bvksound/differentialprobe/DOCUMENTS/Links.txt

https://www.eevblog.com/forum/projects/high-voltage-differential-probe-design-for-review/25/
https://www.eevblog.com/forum/testgear/teardown-pintek-dp-25-differentail-probe/
https://www.eevblog.com/forum/testgear/_new-pro_-differential-probe/msg624988/#msg624988
http://bardagjy.com/?p=1664
http://electronicsplayground.blogspot.com/2015/07/high-voltage-differential-probe-design.html
