bvksound/differentialprobe/BOM/DifferentialProbe_BOM.xlsx

Sheet: BOM_THT
Component | Identical Parts | Section | Type | Part Number / Value | Obtainable | Remark | Alternative Found | Link 1 | Unit Price 1 | Link 2 | Unit Price 2 | Link 3 | Unit Price 3
C1 | C1,2,3,4,5,6 | Input Attenuation Stage | Ceramic Capacitor | 6n8F | Yes |  |  | HSE682SAQCF0KR Vishay / Draloric | Mouser Belgium (https://www.mouser.be/ProductDetail/Vishay-Draloric/HSE682SAQCF0KR?qs=6lQ0QAtkVxmQt2Vp%252BwyNXA%3D%3D) | 0.474
C2 | C1,2,3,4,5,6 | Input Attenuation Stage | Ceramic Capacitor | 6n8F | Yes |  |  | HSE682SAQCF0KR Vishay / Draloric | Mouser Belgium (https://www.mouser.be/ProductDetail/Vishay-Draloric/HSE682SAQCF0KR?qs=6lQ0QAtkVxmQt2Vp%252BwyNXA%3D%3D) | 0.474
C3 | C1,2,3,4,5,6 | Input Attenuation Stage | Ceramic Capacitor | 6n8F | Yes |  |  | HSE682SAQCF0KR Vishay / Draloric | Mouser Belgium (https://www.mouser.be/ProductDetail/Vishay-Draloric/HSE682SAQCF0KR?qs=6lQ0QAtkVxmQt2Vp%252BwyNXA%3D%3D) | 0.474
C4 | C1,2,3,4,5,6 | Input Attenuation Stage | Ceramic Capacitor | 6n8F | Yes |  |  | HSE682SAQCF0KR Vishay / Draloric | Mouser Belgium (https://www.mouser.be/ProductDetail/Vishay-Draloric/HSE682SAQCF0KR?qs=6lQ0QAtkVxmQt2Vp%252BwyNXA%3D%3D) | 0.474
C5 | C1,2,3,4,5,6 | Input Attenuation Stage | Ceramic Capacitor | 6n8F | Yes |  |  | HSE682SAQCF0KR Vishay / Draloric | Mouser Belgium (https://www.mouser.be/ProductDetail/Vishay-Draloric/HSE682SAQCF0KR?qs=6lQ0QAtkVxmQt2Vp%252BwyNXA%3D%3D) | 0.474
C6 | C1,2,3,4,5,6 | Input Attenuation Stage | Ceramic Capacitor | 6n8F | Yes |  |  | HSE682SAQCF0KR Vishay / Draloric | Mouser Belgium (https://www.mouser.be/ProductDetail/Vishay-Draloric/HSE682SAQCF0KR?qs=6lQ0QAtkVxmQt2Vp%252BwyNXA%3D%3D) | 0.474
C7 | C7,11 | Input Attenuation Stage | Ceramic Capacitor | 120pF | Yes |  |  | CC45SL3AD121JYVNA TDK | Mouser Belgium (https://www.mouser.be/ProductDetail/TDK/CC45SL3AD121JYVNA?qs=eSfX1CQlHqq1jQpjjENGKQ%3D%3D) | 0.27
C8 | C8,9,12,13 | Input Attenuation Stage | Ceramic Capacitor | 82pF | Yes |  |  | CC45SL3AD820JYNNA TDK | Mouser Belgium (https://www.mouser.be/ProductDetail/TDK/CC45SL3AD820JYNNA?qs=2FIyTMJ0hNlY1vHleNE%252B0A%3D%3D) | 0.26
C9 | C8,9,12,13 | Input Attenuation Stage | Ceramic Capacitor | 82pF | Yes |  |  | CC45SL3AD820JYNNA TDK | Mouser Belgium (https://www.mouser.be/ProductDetail/TDK/CC45SL3AD820JYNNA?qs=2FIyTMJ0hNlY1vHleNE%252B0A%3D%3D) | 0.26
C10 | C10,14 | Input Attenuation Stage | Variable Capacitor | 8.0-30.0pF |  | Variable capacitor for adjusting square wave compensation and high frequency CMRR |  | JZ300 Knowles Voltronics | Mouser Belgium (https://www.mouser.be/ProductDetail/Knowles-Voltronics/JZ300?qs=l0I8jaqwYiDrMk2Sd%252BO3uQ%3D%3D) | 2.72
C11 | C7,11 | Input Attenuation Stage | Ceramic Capacitor | 120pF | Yes |  |  | CC45SL3AD121JYVNA TDK | Mouser Belgium (https://www.mouser.be/ProductDetail/TDK/CC45SL3AD121JYVNA?qs=eSfX1CQlHqq1jQpjjENGKQ%3D%3D) | 0.27
C12 | C8,9,12,13 | Input Attenuation Stage | Ceramic Capacitor | 82pF | Yes |  |  | CC45SL3AD820JYNNA TDK | Mouser Belgium (https://www.mouser.be/ProductDetail/TDK/CC45SL3AD820JYNNA?qs=2FIyTMJ0hNlY1vHleNE%252B0A%3D%3D) | 0.26
C13 | C8,9,12,13 | Input Attenuation Stage | Ceramic Capacitor | 82pF | Yes |  |  | CC45SL3AD820JYNNA TDK | Mouser Belgium (https://www.mouser.be/ProductDetail/TDK/CC45SL3AD820JYNNA?qs=2FIyTMJ0hNlY1vHleNE%252B0A%3D%3D) | 0.26
C14 | C10,14 | Input Attenuation Stage | Variable Capacitor | 8.0-30.0pF |  | Variable capacitor for adjusting square wave compensation. |  | JZ300 Knowles Voltronics | Mouser Belgium (https://www.mouser.be/ProductDetail/Knowles-Voltronics/JZ300?qs=l0I8jaqwYiDrMk2Sd%252BO3uQ%3D%3D) | 2.72
C15 |  | JFET Buffer and Gain Stage | Ceramic Capacitor | 22pF | Yes |  |  | 1C10C0G220J050B Vishay | Mouser Belgium (https://www.mouser.be/ProductDetail/Vishay/1C10C0G220J050B?qs=%2FVYrxewl4mYopKLzL8PbyA%3D%3D) | 0.15
C16 | C16,19,20,21,26 | JFET Buffer and Gain Stage | Ceramic Capacitor | 100nF | Yes |  |  | Multilayer Ceramic Capacitor, 0.1 uF, 50 V, Mono-Kap Series, ± 10%, Radial Leaded, X7R (farnell.com) (https://be.farnell.com/vishay/k104k15x7rf53h5/cap-0-1-f-50v-10-x7r/dp/1141777) | 0.095
C17 |  | JFET Buffer and Gain Stage | Ceramic Capacitor | 68pF | Yes |  |  | D680J25SL0L6UJ5R Vishay / BC Components | Mouser Belgique (https://www.mouser.be/ProductDetail/Vishay-BC-Components/D680J25SL0L6UJ5R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) | 0.11
C18 |  | JFET Buffer and Gain Stage | Ceramic Capacitor | 33pF | Yes |  |  | CC45SL3DD330JYGNA TDK | Mouser Belgique (https://www.mouser.be/ProductDetail/TDK/CC45SL3DD330JYGNA?qs=eSfX1CQlHqpvQOwssXPbQg%3D%3D) | 0.31
C19 | C16,19,20,21,26 | JFET Buffer and Gain Stage | Ceramic Capacitor | 100nF | Yes |  |  | Multilayer Ceramic Capacitor, 0.1 uF, 50 V, Mono-Kap Series, ± 10%, Radial Leaded, X7R (farnell.com) (https://be.farnell.com/vishay/k104k15x7rf53h5/cap-0-1-f-50v-10-x7r/dp/1141777) | 0.095
C20 | C16,19,20,21,26 | JFET Buffer and Gain Stage | Ceramic Capacitor | 100nF | Yes |  |  | Multilayer Ceramic Capacitor, 0.1 uF, 50 V, Mono-Kap Series, ± 10%, Radial Leaded, X7R (farnell.com) (https://be.farnell.com/vishay/k104k15x7rf53h5/cap-0-1-f-50v-10-x7r/dp/1141777) | 0.095
C21 | C16,19,20,21,26 | JFET Buffer and Gain Stage | Ceramic Capacitor | 100nF | Yes |  |  | Multilayer Ceramic Capacitor, 0.1 uF, 50 V, Mono-Kap Series, ± 10%, Radial Leaded, X7R (farnell.com) (https://be.farnell.com/vishay/k104k15x7rf53h5/cap-0-1-f-50v-10-x7r/dp/1141777) | 0.095
C22 |  | JFET Buffer and Gain Stage | Ceramic Capacitor | 10nF | Yes |  |  | D103K43Y5PH6TJ5R Vishay / BC Components | Mouser Belgique (https://www.mouser.be/ProductDetail/Vishay-BC-Components/D103K43Y5PH6TJ5R?qs=wEmTtUuRSe6NCZwQxzdYuQ%3D%3D) | 0.29
C23 | C23,24 | Output Stage | Ceramic Capacitor | 6p8F | Yes |  |  | 561R10TCCV68BA Vishay / Cera-Mite | Mouser Belgique (https://www.mouser.be/ProductDetail/Vishay-Cera-Mite/561R10TCCV68BA?qs=XeJOwCSCkv%252BIxAC3i6sxEw%3D%3D) | 0.46
C24 | C23,24 | JFET Buffer and Gain Stage | Ceramic Capacitor | 6p8F | Yes |  |  | 561R10TCCV68BA Vishay / Cera-Mite | Mouser Belgique (https://www.mouser.be/ProductDetail/Vishay-Cera-Mite/561R10TCCV68BA?qs=XeJOwCSCkv%252BIxAC3i6sxEw%3D%3D) | 0.46
C26 | C16,19,20,21,26 | Output Stage | Ceramic Capacitor | 100nF | Yes |  |  | Multilayer Ceramic Capacitor, 0.1 uF, 50 V, Mono-Kap Series, ± 10%, Radial Leaded, X7R (farnell.com) (https://be.farnell.com/vishay/k104k15x7rf53h5/cap-0-1-f-50v-10-x7r/dp/1141777) | 0.095
C27 |  | Power Supply | Tantalum Capacitor | 4u7F 16V | Yes
C28 |  | Power Supply | Tantalum Capacitor | 4u7F 16V | Yes
C29 |  | Power Supply | Tantalum Capacitor | 4u7F 16V | Yes
C30 |  | Power Supply | Ceramic Capacitor | 100nF | Yes
C31 |  | Power Supply | Ceramic Capacitor | 33nF | Yes
C32 |  | Power Supply | Tantalum Capacitor | 1uF 25V | Yes
C33 |  | Power Supply | Ceramic Capacitor | 100nF | Yes
C34 |  | Power Supply | Ceramic Capacitor | 1nF | Yes
C36 |  | Power Supply | Tantalum Capacitor | 4u7F 16V | Yes
C39 |  | Output Stage | Ceramic Capacitor | Not Fitted |  | Not Fitted
C40 |  | Power Supply | Tantalum Capacitor | 1uF 16V | Yes
C41 |  | Power Supply | Tantalum Capacitor | 22uF 16V | Yes
R1a | R1a,1b,2a,2b,3a,3b,4a,4c | Input Attenuation Stage | Resistor | 1M | Yes |  |  | Through Hole Resistor, 1 Mohm, R Series, 250 mW, ± 0.1%, Axial Leaded, 500 V (farnell.com) (https://be.farnell.com/neohm-te-connectivity/yr1b1m0cc/res-1m-0-10-250mw-axial-metal/dp/1083579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) | 0.664
R1b | R1a,1b,2a,2b,3a,3b,4a,4c | Input Attenuation Stage | Resistor | 1M | Yes |  |  | Through Hole Resistor, 1 Mohm, R Series, 250 mW, ± 0.1%, Axial Leaded, 500 V (farnell.com) (https://be.farnell.com/neohm-te-connectivity/yr1b1m0cc/res-1m-0-10-250mw-axial-metal/dp/1083579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) | 0.664
R2a | R1a,1b,2a,2b,3a,3b,4a,4c | Input Attenuation Stage | Resistor | 1M | Yes |  |  | Through Hole Resistor, 1 Mohm, R Series, 250 mW, ± 0.1%, Axial Leaded, 500 V (farnell.com) (https://be.farnell.com/neohm-te-connectivity/yr1b1m0cc/res-1m-0-10-250mw-axial-metal/dp/1083579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) | 0.664
R2b | R1a,1b,2a,2b,3a,3b,4a,4c | Input Attenuation Stage | Resistor | 1M | Yes |  |  | Through Hole Resistor, 1 Mohm, R Series, 250 mW, ± 0.1%, Axial Leaded, 500 V (farnell.com) (https://be.farnell.com/neohm-te-connectivity/yr1b1m0cc/res-1m-0-10-250mw-axial-metal/dp/1083579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) | 0.664
R3a | R1a,1b,2a,2b,3a,3b,4a,4c | Input Attenuation Stage | Resistor | 1M | Yes |  |  | Through Hole Resistor, 1 Mohm, R Series, 250 mW, ± 0.1%, Axial Leaded, 500 V (farnell.com) (https://be.farnell.com/neohm-te-connectivity/yr1b1m0cc/res-1m-0-10-250mw-axial-metal/dp/1083579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) | 0.664
R3b | R1a,1b,2a,2b,3a,3b,4a,4c | Input Attenuation Stage | Resistor | 1M | Yes |  |  | Through Hole Resistor, 1 Mohm, R Series, 250 mW, ± 0.1%, Axial Leaded, 500 V (farnell.com) (https://be.farnell.com/neohm-te-connectivity/yr1b1m0cc/res-1m-0-10-250mw-axial-metal/dp/1083579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) | 0.664
R4a | R1a,1b,2a,2b,3a,3b,4a,4c | Input Attenuation Stage | Resistor | 1M | Yes |  |  | Through Hole Resistor, 1 Mohm, R Series, 250 mW, ± 0.1%, Axial Leaded, 500 V (farnell.com) (https://be.farnell.com/neohm-te-connectivity/yr1b1m0cc/res-1m-0-10-250mw-axial-metal/dp/1083579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) | 0.664
R4b | R1a,1b,2a,2b,3a,3b,4a,4c | Input Attenuation Stage | Resistor | 1M | Yes |  |  | Through Hole Resistor, 1 Mohm, R Series, 250 mW, ± 0.1%, Axial Leaded, 500 V (farnell.com) (https://be.farnell.com/neohm-te-connectivity/yr1b1m0cc/res-1m-0-10-250mw-axial-metal/dp/1083579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) | 0.664
R5 | R5,6 | Input Attenuation Stage | Resistor | 26K1 | Yes |  |  | Through Hole Resistor, 26.1 kohm, MCMF0W4 Series, 250 mW, ± 0.5%, Axial Leaded, 250 V (farnell.com) (https://be.farnell.com/multicomp/mcmf0w4df2612a50/res-26k1-0-50-250mw-axial/dp/1563153) | 0.12
R6 | R5,6 | Input Attenuation Stage | Resistor | 26K1 | Yes |  |  | Through Hole Resistor, 26.1 kohm, MCMF0W4 Series, 250 mW, ± 0.5%, Axial Leaded, 250 V (farnell.com) (https://be.farnell.com/multicomp/mcmf0w4df2612a50/res-26k1-0-50-250mw-axial/dp/1563153) | 0.12
R7 |  | Output Stage | Resistor | 7R5 | Yes |  |  | Through Hole Resistor, 7.5 ohm, LR Series, 600 mW, ± 1%, Axial Leaded, 350 V (farnell.com) (https://be.farnell.com/te-connectivity/lr1f7r5/res-7r5-1-600mw-axial-metal-film/dp/2330224?st=7r5) | 0.074
R8 |  | JFET Buffer and Gain Stage | Resistor | 3K48 | Yes |  |  | Through Hole Resistor, 3.48 kohm, MRS25 Series, 600 mW, ± 1%, Axial Leaded, 350 V (farnell.com) (https://be.farnell.com/vishay/mrs25000c3481fct00/res-3k48-1-600mw-axial-metal-film/dp/9467858?st=3k48) | 0.094
R9 |  | JFET Buffer and Gain Stage | Resistor | 4K02 | Yes |  |  | Through Hole Resistor, 4.02 kohm, MRS25 Series, 600 mW, ± 1%, Axial Leaded, 350 V (farnell.com) (https://be.farnell.com/vishay/mrs25000c4021fct00/res-4k02-1-600mw-axial-metal-film/dp/9468617) | 0.121
R10 |  | JFET Buffer and Gain Stage | Resistor | 374R | Yes |  |  | Through Hole Resistor, 374 ohm, MRS25 Series, 600 mW, ± 1%, Axial Leaded, 350 V (farnell.com) (https://be.farnell.com/vishay/mrs25000c3740fct00/res-374r-1-600mw-axial-metal-film/dp/9467602?st=374r) | 0.666
R11 |  | JFET Buffer and Gain Stage | Resistor | 18K | Yes |  |  | Through Hole Resistor, 18 kohm, MCRE Series, 125 mW, ± 5%, Axial Leaded, 200 V (farnell.com) (https://be.farnell.com/multicomp/mcre000052/res-18k-5-125mw-axial-carbon-film/dp/1700254) | 0.021
R12 | R12,13 | JFET Buffer and Gain Stage | Resistor | 2K2 | Yes |  |  | Through Hole Resistor, 2.2 kohm, MFR Series, 400 mW, ± 1%, Axial Leaded, 200 V (farnell.com) (https://be.farnell.com/tt-electronics-welwyn/mfr3-2k2fc/res-2k2-1-400mw-axial-metal-film/dp/1565301) | 0.071
R13 | R12,13 | JFET Buffer and Gain Stage | Resistor | 2K2 | Yes |  |  | Through Hole Resistor, 2.2 kohm, MFR Series, 400 mW, ± 1%, Axial Leaded, 200 V (farnell.com) (https://be.farnell.com/tt-electronics-welwyn/mfr3-2k2fc/res-2k2-1-400mw-axial-metal-film/dp/1565301) | 0.071
R14 |  | JFET Buffer and Gain Stage | Resistor | 680R | Yes |  |  | Through Hole Resistor, 680 ohm, MF25 Series, 250 mW, ± 1%, Axial Leaded, 250 V (farnell.com) (https://be.farnell.com/multicomp/mf25-680r/res-680r-1-250mw-axial-metal-film/dp/9342150?st=680r) | 0.0385
R15 | R15,17 | JFET Buffer and Gain Stage | Resistor | 210R | Yes |  |  | MFR-25FBF52-210R Yageo | Mouser Belgium (https://www.mouser.be/ProductDetail/Yageo/MFR-25FBF52-210R?qs=oAGoVhmvjhwWKFUNNlqasw%3D%3D) | 0.085
R16 |  | JFET Buffer and Gain Stage | Resistor | 680R | Yes |  |  | Through Hole Resistor, 680 ohm, MF25 Series, 250 mW, ± 1%, Axial Leaded, 250 V (farnell.com) (https://be.farnell.com/multicomp/mf25-680r/res-680r-1-250mw-axial-metal-film/dp/9342150?st=680r) | 0.0385
R17 | R15,17 | JFET Buffer and Gain Stage | Resistor | 210R | Yes |  |  | MFR-25FBF52-210R Yageo | Mouser Belgium (https://www.mouser.be/ProductDetail/Yageo/MFR-25FBF52-210R?qs=oAGoVhmvjhwWKFUNNlqasw%3D%3D) | 0.085
R18 |  | JFET Buffer and Gain Stage | Resistor | 620R | Yes |  |  | Through Hole Resistor, 620 ohm, MRS25 Series, 600 mW, ± 1%, Axial Leaded, 350 V (farnell.com) (https://be.farnell.com/vishay/mrs25000c6200fct00/res-620r-1-600mw-axial-metal-film/dp/9469478) | 0.088
R19 |  | JFET Buffer and Gain Stage | Resistor | 6K8 | Yes |  |  | Through Hole Resistor, 6.8 kohm, MFR Series, 400 mW, ± 1%, Axial Leaded, 200 V (farnell.com) (https://be.farnell.com/tt-electronics-welwyn/mfr3-6k8fc/res-6k8-1-400mw-axial-metal-film/dp/1565329) | 0.059
R20 |  | JFET Buffer and Gain Stage | Resistor | 510R | Yes |  |  | Through Hole Resistor, 510 ohm, MF12 Series, 125 mW, ± 1%, Axial Leaded, 200 V (farnell.com) (https://be.farnell.com/multicomp/mf12-510r/res-510r-1-125mw-axial-metal-film/dp/9343300?st=510r) | 0.031
R21 | R21,22 | Output Stage | Resistor | 4K42 | Yes |  |  | Through Hole Resistor, 4.42 kohm, MRS25 Series, 600 mW, ± 1%, Axial Leaded, 350 V (farnell.com) (https://be.farnell.com/vishay/mrs25000c4421fct00/res-4k42-1-600mw-axial-metal-film/dp/9468668?st=4k42) | 0.117
R22 | R21,22 | JFET Buffer and Gain Stage | Resistor | 4K42 | Yes |  |  | Through Hole Resistor, 4.42 kohm, MRS25 Series, 600 mW, ± 1%, Axial Leaded, 350 V (farnell.com) (https://be.farnell.com/vishay/mrs25000c4421fct00/res-4k42-1-600mw-axial-metal-film/dp/9468668?st=4k42) | 0.117
R23 |  | Power Supply | Resistor | 10K | Yes
R24 |  | Power Supply | Resistor | 100K | Yes
R25 |  | Power Supply | Resistor | 36K | Yes
R26 |  | Power Supply | Resistor | 1K | Yes
R27 |  | Power Supply | Resistor | 150R | Yes
R28 |  | Power Supply | Resistor | 33K | Yes
R29 |  | Power Supply | Resistor | 82K | Yes
R30 |  | Power Supply | Resistor | Not Fitted
R33 |  | Power Supply | Resistor | 56K | Yes
R34 |  | Power Supply | Resistor | 510K | Yes
R35 |  | Power Supply | Resistor | 100K | Yes
R36 |  | Power Supply | Resistor | 56K | Yes
R37 |  | Power Supply | Resistor | 18K | Yes
R38 |  | Power Supply | Resistor | 82K | Yes
R39 |  | Power Supply | Resistor | 18K | Yes
VR1 |  | Input Attenuation Stage | Trim Resistor | 500R | Yes | Variable resistor for adjusting low frequency CMRR. |  | Trimpot, Multi Turn, Cermet, Top Adjust, 500 ohm, Through Hole, 23 Turns (farnell.com) (https://be.farnell.com/vishay/t93yb501kt20/trimmer-pot-500r-23turn-thd/dp/1141414?st=trimpot) | 1.36
VR2 |  | JFET Buffer and Gain Stage | Trim Resistor | 1K0 | Yes | Variable resistor for adjusting offset when SW1 at attenuation 1/100. |  | Trimpot, Multi Turn, Cermet, Top Adjust, 1 kohm, Through Hole, 20 Turns (farnell.com) (https://be.farnell.com/bi-technologies-tt-electronics/67wr1klf/trimmer-potentiometer-1kohm-20turn/dp/2113000) | 1.35
VR3 |  | JFET Buffer and Gain Stage | Trim Resistor | 500R | Yes | Variable resistor for adjusting accuracy. |  | Trimpot, Single Turn, Cermet, Top Adjust, 500 ohm, Through Hole, 1 Turns (farnell.com) (https://be.farnell.com/bourns/3362p-1-501lf/trimmer-500r/dp/9354360) | 1.44
VR4 |  | Output Stage | Trim Resistor | 100K | Yes | Variable resistor for adjusting offset when SW1 at attenuation 1/10. |  | Trimpot, Multi Turn, Cermet, Top Adjust, 100 kohm, Through Hole, 23 Turns (farnell.com) (https://be.farnell.com/vishay/m64w104kb40/trimmer-pot-100k-23turn-thd/dp/9608656) | 1.94
U1 |  | JFET Buffer and Gain Stage | JFET | U441NL | Yes | Other have seen 2N3958 | IFN441 | IFN411 InterFET | Mouser Belgium (https://www.mouser.be/ProductDetail/InterFET/IFN411?qs=ggD623E1wpTqTvB4DJqgbw%3D%3D) | 24.6
U2 |  | JFET Buffer and Gain Stage | Transistor Array | LM3406M | Yes | Typo in schematic, part is LM3046M instead of LM3406M | HFA3046BZ | Bipolar Transistor Array, NPN, 12 V, 34 mA, 150 mW, 40 hFE, SOIC (farnell.com) (https://be.farnell.com/renesas/hfa3046bz/transistor-npn-12v-0-15w-soic/dp/2983709?ost=hfa3046) | 10.49
U3 |  | Output Stage | OPAMP | AD797ARZ | Yes | Somebody read LM6365M on their version |  | Operational Amplifier, Single, 1 Amplifier, 110 MHz, 20 V/us, ± 5V to ± 18V, DIP, 8 Pins (farnell.com) (https://be.farnell.com/analog-devices/ad797anz/ic-op-amp-u-low-noise-dip8-797/dp/9603778?st=ad797) | 12.48
U4 |  | Power Supply | Timer | NE555 | Yes
D1 |  | Input Attenuation Stage | Diode | 1N4148 | Yes |  |  | Small Signal Diode, Single, 100 V, 200 mA, 1 V, 4 ns, 1 A (farnell.com) (https://be.farnell.com/on-semiconductor/1n4148tr/diode-100v-200ma-do-35/dp/9843680?st=1n4148) | 0.122
D2 |  | Input Attenuation Stage | Diode | 1N4148 | Yes |  |  | Small Signal Diode, Single, 100 V, 200 mA, 1 V, 4 ns, 1 A (farnell.com) (https://be.farnell.com/on-semiconductor/1n4148tr/diode-100v-200ma-do-35/dp/9843680?st=1n4148) | 0.122
D3 |  | General | Diode | Led Red 3mm | Yes |  |  | LED, Green, Through Hole, T-1 (3mm), 20 mA, 2.1 V, 570 nm (farnell.com) (https://be.farnell.com/multicomp/mcl034gd/led-3mm-70-green/dp/1581114?st=led%20green%203mm) | 0.083
D4 |  | Power Supply | Diode | 1N4148 | Yes
D5 |  | Power Supply | Diode | 1N4148 | Yes
D6 |  | Power Supply | Diode | 1N4001 | Yes
D7 |  | Power Supply | Diode | 1N4001 | Yes
D8 |  | Power Supply | Diode | 1N4148 | Yes
D9 |  | Power Supply | Diode | 1N4148 | Yes
D10 |  | Power Supply | Diode | 1N4148 | Yes
D11 |  | Power Supply | Diode | 1N4148 | Yes
L1 |  | Power Supply | Inductor | 220uH | Yes
L2 |  | Power Supply | Inductor | 220uH | Yes
L3 |  | Power Supply | Inductor | 220uH | Yes
L4 |  | Power Supply | Inductor | 220uH | Yes
L5 |  | Power Supply | Inductor | 220uH | Yes
T1 |  | Power Supply | Transformer | HPR-6856 | No |  | Original Part shows T-102 YN
Q1 |  | JFET Buffer and Gain Stage | Transistor | 2N2222A | Yes |  |  | Single Bipolar Transistor (BJT), High Speed Switching, NPN, 40 V, 1.2 W, 800 mA, TO-18 (farnell.com) (https://be.farnell.com/multicomp/2n2222a/transistor-npn-40v-800ma-to-18/dp/9207120?st=2n2222a) | 1.22
Q2 |  | JFET Buffer and Gain Stage | Transistor | 2N2907A | Yes |  |  | Bipolar (BJT) Single Transistor, PNP, 60 V, 600 mA, 400 mW, TO-18, Through Hole (farnell.com) (https://be.farnell.com/multicomp/2n2907a/transistor-pnp-60v-0-6a-to-18/dp/9206914?st=2n2907a) | 1.17
Q3 |  | Power Supply | Voltage Reference | TL431 | Yes
Q4 |  | Power Supply | Transistor | BF451 | No
Q5 |  | Power Supply | Voltage Reference | TL431 | Yes
Q6 |  | Power Supply | Transistor | 2N2222A | Yes
SW1 | SW1,2 | JFET Buffer and Gain Stage | Switch |  | Yes | Attenuator Switch |  | Slide Switch, SPDT, Through Hole, SSSF Series, 100 mA (farnell.com) (https://be.farnell.com/alps-alpine/sssf011700/slide-switch-spdt-0-1a-30v-tht/dp/3261774?st=switch%20slide) | 0.723
SW2 | SW1,2 | Power Supply | Switch |  | Yes | Power Switch |  | Slide Switch, SPDT, Through Hole, SSSF Series, 100 mA (farnell.com) (https://be.farnell.com/alps-alpine/sssf011700/slide-switch-spdt-0-1a-30v-tht/dp/3261774?st=switch%20slide) | 0.724
CON1 |  | Power Supply | DC Barrel Jack |  | Yes |  |  | DC Power Connector, Receptacle, 2.1 mm, PCB Mount, Solder (farnell.com) (https://be.farnell.com/pro-power/ppw01010/2-1mm-dc-socket-locking/dp/3498419?st=dc%20barrel%20jack) | 0.637
 |  |  |  |  |  |  |  | Total: | 77.9090

Sheet: BOM_SMT
Component | Identical Parts | Type | Part Number / Value | Size | Obtainable | Remark | Alternative Found | Link 1 | Unit Price 1 | Link 2 | Unit Price 2 | Link 3 | Unit Price 3

Sheet: Lists
List 1
Yes
No
