bvksound/differentialprobe/CAD/BoardOutline.dxf

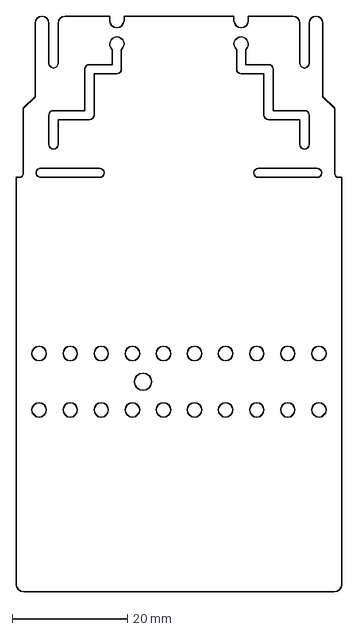
[picture p1: CAD file, 2021-05-24]
CAD/BoardOutline.dxf
56.5 x 100.0 mm
