bvksound/differentialprobe/DOCUMENTS/Diff Probe.PDF

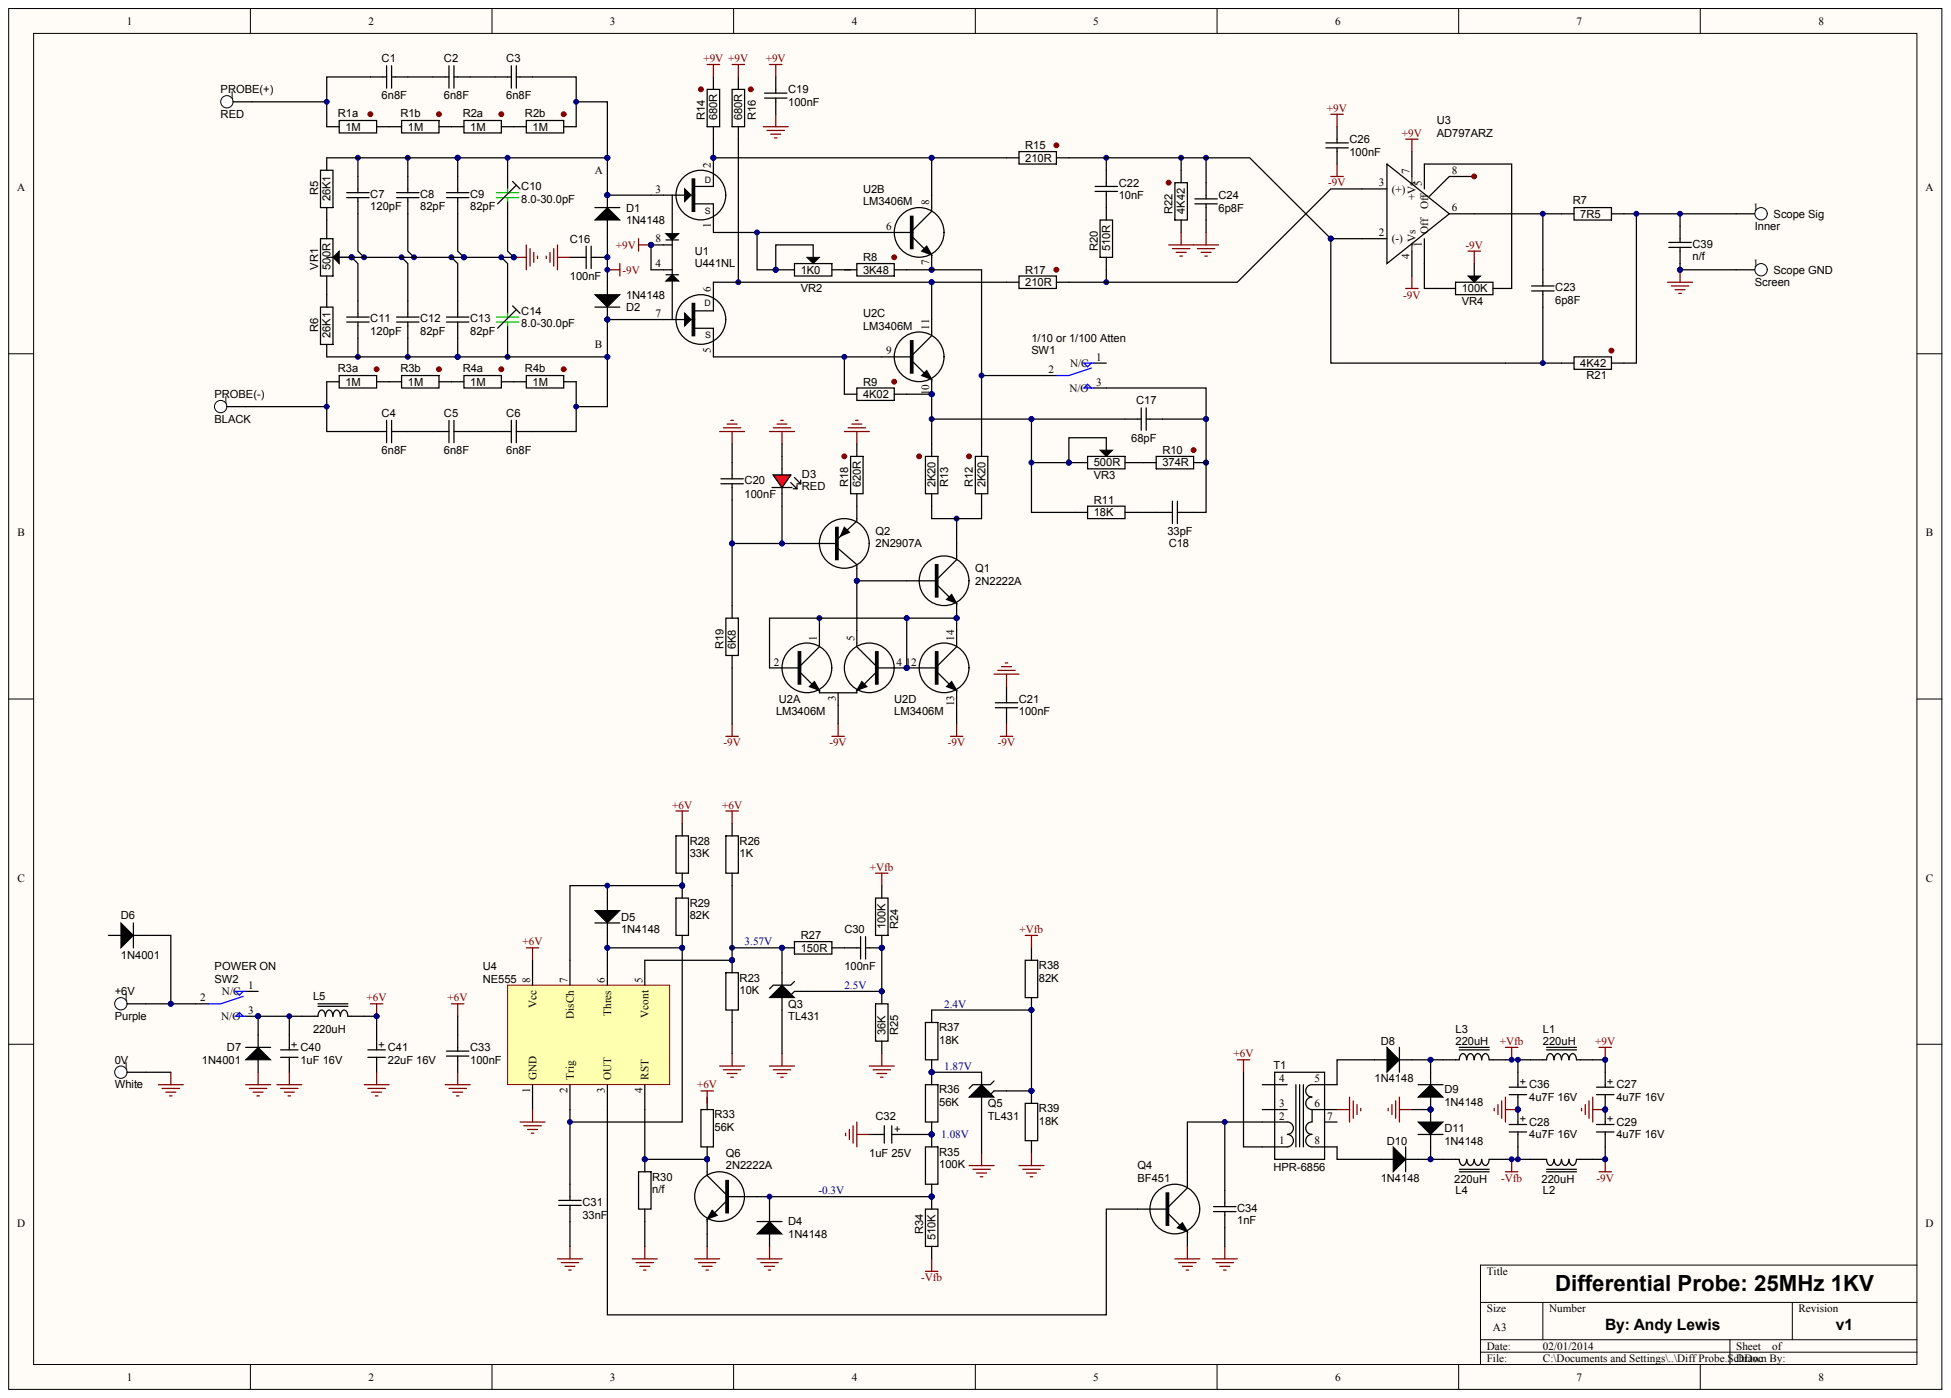
[picture p2: page 1]
