bvksound/differentialprobe/PCB/DifferentialProbe/DifferentialProbe.kicad_pcb

## KiCad design PCB/DifferentialProbe/DifferentialProbe.kicad_pcb (2021-05-27)

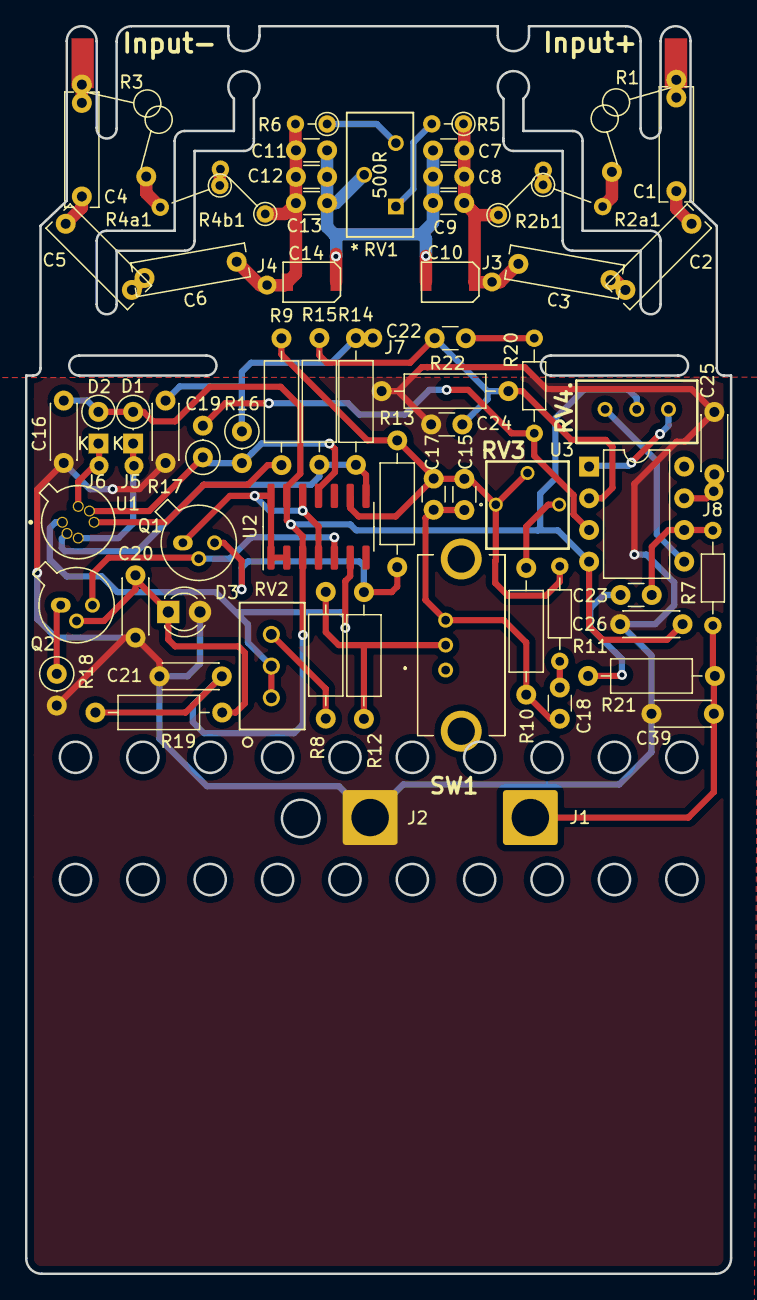
[picture p3: board DifferentialProbe.kicad_pcb from above]

Board: 2 copper layers, 56.5 x 100.0 mm, 74 parts (0 on the bottom side), 39 nets.

Parts:
C1, C2, C3, C4, C5, C6: 6n8F; C_Rect_L9.0mm_W2.5mm_P7.50mm_MKT
C7, C11: 120pF; C_Disc_D3.0mm_W1.6mm_P2.50mm
C8, C9, C12, C13: 82pF; C_Disc_D3.0mm_W1.6mm_P2.50mm
C10, C14: 8-30pF; JZ300
C15: 22pF; C_Disc_D3.0mm_W1.6mm_P2.50mm
C16, C19, C20, C21, C25, C26: 100nF; C_Disc_D4.3mm_W1.9mm_P5.00mm
C17: 68pF; C_Disc_D3.0mm_W1.6mm_P2.50mm
C18: 33pF; C_Disc_D3.0mm_W1.6mm_P2.50mm
C22: 10nF; C_Disc_D3.0mm_W1.6mm_P2.50mm
C23, C24: 6p8F; C_Disc_D3.0mm_W1.6mm_P2.50mm
C39: Not Fitted; C_Disc_D4.3mm_W1.9mm_P5.00mm
D1, D2: 1N4148; D_DO-35_SOD27_P2.54mm_Vertical_KathodeUp
D3: LED; LED_D3.0mm
J1: Scope Signal; SolderWire-2.5sqmm_1x01_D2.4mm_OD4.4mm
J2: Scope Ground / Screen; SolderWire-2.5sqmm_1x01_D2.4mm_OD4.4mm
J3, J5: Wire A; Wire_Hole
J4, J6: Wire B; Wire_Hole
J7, J8: Wire +9V; Wire_Hole
Probe+1: Pad_Single; PAD_1_8x4mm_Single
Probe-1: Pad_Single; PAD_1_8x4mm_Single
Q1: 2N2222A; TO-18-3
Q2: 2N2907A; TO-18-3
R1, R3: 2M_Series_Resistor; 2M_Series
R2a1, R2b1, R4a1, R4b1: 1M; R_Axial_DIN0204_L3.6mm_D1.6mm_P5.08mm_Vertical
R5, R6: 26K1; R_Axial_DIN0204_L3.6mm_D1.6mm_P2.54mm_Vertical
R7: 7R5; R_Axial_DIN0204_L3.6mm_D1.6mm_P7.62mm_Horizontal
R8: 3K48; R_Axial_DIN0207_L6.3mm_D2.5mm_P10.16mm_Horizontal
R9: 4K02; R_Axial_DIN0207_L6.3mm_D2.5mm_P10.16mm_Horizontal
R10: 374R; R_Axial_DIN0207_L6.3mm_D2.5mm_P10.16mm_Horizontal
R11: 18K; R_Axial_DIN0204_L3.6mm_D1.6mm_P7.62mm_Horizontal
R12, R13: 2K2; R_Axial_DIN0207_L6.3mm_D2.5mm_P10.16mm_Horizontal
R14: 680R; R_Axial_DIN0207_L6.3mm_D2.5mm_P10.16mm_Horizontal
R15: 210R; R_Axial_DIN0207_L6.3mm_D2.5mm_P10.16mm_Horizontal
R16: 680R; R_Axial_DIN0207_L6.3mm_D2.5mm_P2.54mm_Vertical
R17: 210R; R_Axial_DIN0207_L6.3mm_D2.5mm_P2.54mm_Vertical
R18: 620R; R_Axial_DIN0207_L6.3mm_D2.5mm_P2.54mm_Vertical
R19: 6K8; R_Axial_DIN0207_L6.3mm_D2.5mm_P10.16mm_Horizontal
R20: 510R; R_Axial_DIN0204_L3.6mm_D1.6mm_P7.62mm_Horizontal
R21, R22: 4K42; R_Axial_DIN0207_L6.3mm_D2.5mm_P10.16mm_Horizontal
RV1: 500R; T93YB 500K 10&percent_ TU
RV2: 1K; 67WR10KLF
RV3: 500R; 3362P_1
RV4: 100K; 64W_1
SW1: Attenuation Switch; SSSF011700
U1: IFNU411; TO-71
U2: HFA3046BZ; SOIC-14_3.9x8.7mm_P1.27mm
U3: AD797; DIP-8_W7.62mm

Connections:
+9V: C19.1, C25.1, J7.1, J8.1, R14.1, R16.1, U3.7
-9V: C16.2, C21.2, C26.1, D1.2, D2.2, R19.1, RV4.2, U2.3, U2.13, U3.4
GND: C7.1, C8.1, C9.1, C10.2, C11.2, C12.2, C13.2, C14.1, C16.1, C19.2, C20.1, C21.1, C24.1, C25.2, C26.2, C39.2, D3.2, J2.1, R18.2, R22.1, RV1.2
unnamed: C1.1, C2.2
unnamed: C1.2, Probe+1.1, R1.1
unnamed: C2.1, C3.2
unnamed: C4.1, C5.2
unnamed: C4.2, Probe-1.1, R3.1
unnamed: C5.1, C6.2
unnamed: C3.1, C7.2, C8.2, C9.2, C10.1, D1.1, J3.1, J5.1, R2b1.1, R5.1, U1.3
unnamed: C6.1, C11.1, C12.1, C13.1, C14.2, D2.1, J4.1, J6.1, R4b1.1, R6.2, U1.7
unnamed: C15.1, C17.1, C18.1, R10.1, SW1.3
unnamed: C15.2, C17.2, R9.2, R11.2, R13.2, RV3.1, RV3.2, U2.9
unnamed: C18.2, R11.1
unnamed: C20.2, D3.1, Q2.2, R19.2
unnamed: C22.1, R20.1
unnamed: C22.2, C23.1, C24.2, R15.2, R21.1, R22.2, U3.2
unnamed: C23.2, R7.2, U3.6
unnamed: C39.1, J1.1, R7.1, R21.2
unnamed: Q1.1, U2.1, U2.2, U2.4, U2.12, U2.14
unnamed: Q1.2, Q2.3, U2.5
unnamed: Q1.3, R12.1, R13.1
unnamed: Q2.1, R18.1
unnamed: R1.2, R2a1.2
unnamed: R2a1.1, R2b1.2
unnamed: R3.2, R4a1.2
unnamed: R4a1.1, R4b1.2
unnamed: R5.2, RV1.1
unnamed: R6.1, RV1.3
unnamed: R8.1, RV2.3
unnamed: R9.1, U1.5
unnamed: R10.2, RV3.3
unnamed: R8.2, R12.2, SW1.2
unnamed: R14.2, R15.1, U1.2, U2.8
unnamed: R16.2, R17.1, U1.6, U2.11
unnamed: R17.2, R20.2, U3.3
unnamed: RV2.1, RV2.2, U1.1, U2.6
unnamed: RV4.1, U3.5
unnamed: RV4.3, U3.1
