bvksound/differentialprobe/(commit log)

2021-05-17 original schematics added
2021-05-17 supporting documents and draft bom added
    [DifferentialProbe_BOM.xlsx]
2021-05-17 Update with descriptions of variable R and C
    [DifferentialProbe_BOM.xlsx]
2021-05-23 draft design and BOM started
    [BoardOutline.dxf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]
2021-05-24 1st design finished
    [BoardOutline.dxf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]
2021-05-27 finalized rev0 for ordering
    [DifferentialProbe-B_Cu.gbr, DifferentialProbe-B_Mask.gbr, DifferentialProbe-B_Paste.gbr, DifferentialProbe-B_SilkS.gbr, DifferentialProbe-Edge_Cuts.gbr, DifferentialProbe-F_Cu.gbr, DifferentialProbe-F_Mask.gbr, DifferentialProbe-F_Paste.gbr]
